Tasnimanam/An-IV-System-for-Reverse-Blood-Flow-Prevention-and-Infusion-Pump-Based-Drug-Delivery/Full project setup.jpeg

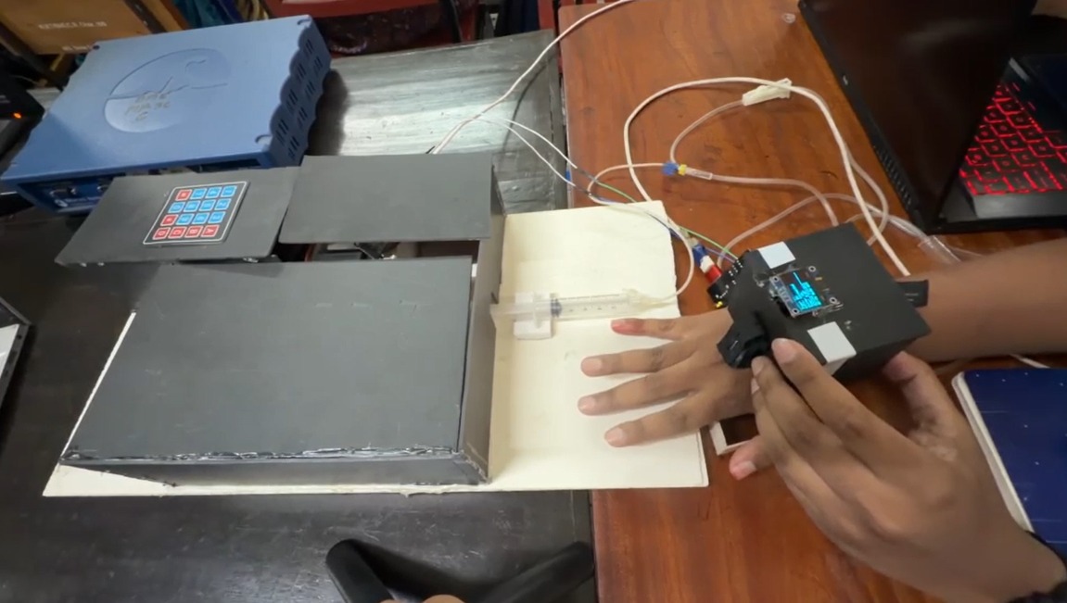
Full project setup.jpeg
