Tasnimanam/An-IV-System-for-Reverse-Blood-Flow-Prevention-and-Infusion-Pump-Based-Drug-Delivery/Web server interface.jpeg

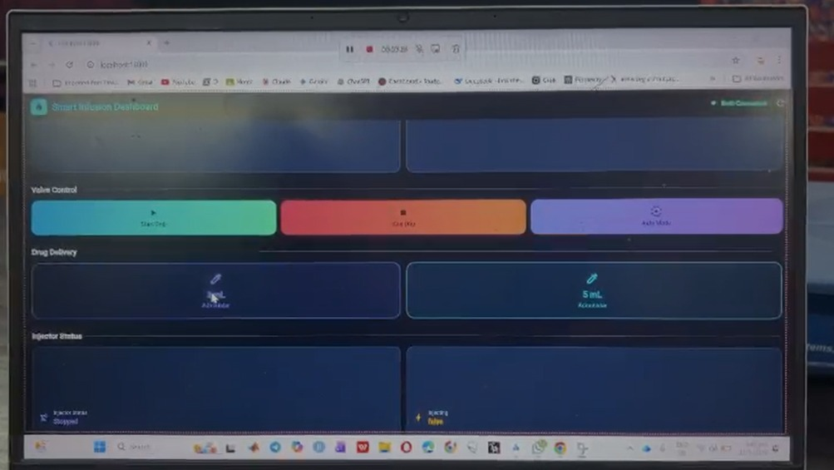
Web server interface.jpeg
