Tasnimanam/An-IV-System-for-Reverse-Blood-Flow-Prevention-and-Infusion-Pump-Based-Drug-Delivery/README.md

# Smart Tele-Controlled IV System for Reverse Blood Flow Prevention and Automated Drug Delivery

## Overview
This project presents an IoT-based smart tele-controlled IV system for reverse blood flow prevention and automated infusion pump-based drug delivery. The system is designed to improve patient safety during IV therapy by combining real-time monitoring, optical backflow detection, and automated medication delivery through a web-based remote monitoring platform.

## Key Features
- Reverse blood flow detection using LED–LDR optical sensing
- Automatic solenoid valve control for backflow prevention
- Automated infusion pump for controlled drug delivery
- Real-time monitoring of:
  - Heart Rate
  - SpO₂
  - Body Temperature
- Web-based dashboard for remote monitoring and control
- ESP32-based wireless communication
- Low-cost and portable biomedical device design

## Technologies Used
- ESP32-S2 Mini
- platform.io (Visual Studio)
- ESP32
- Arduino IDE
- Flutter Web
- SolidWorks
- EasyEDA
- PLA 3D Printing

## Project Files
- `BME 4232 Project Report Group 03.pdf` – Full project report
- `Code_for_Infusion_pump.ino` – Infusion pump control code
- `Codes_for_IV_system.zip` – IV system source files
- `Full project setup.jpeg` – Hardware prototype
- `Web server interface.jpeg` – Dashboard interface

## Team Members
Group 03 – Department of Biomedical Engineering  
Khulna University of Engineering & Technology (KUET)

- Mohammad Nazmul Islam
- Ridoy Saha
- Shithi Datta
- Kaniz Fatema Ratna
- Tasnim Anam Tusti
- Nusrat Jebin Ani

## Outcome
The developed system successfully demonstrated:
- Reverse blood flow detection accuracy of 85%
- Automated valve response for backflow prevention
- Average infusion flow rate of 0.83 mL/sec
- Remote monitoring and control through a web dashboard

## Future Improvements
- Air bubble detection
- Improved medical-grade sensing
- Larger infusion capacity
- Clinical usability enhancement
- Advanced IoT monitoring for hospital applications
